ugate/ugate/README.md

# ugatefx
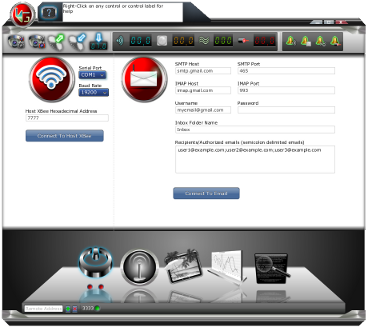
[picture p1: docs/screen01.png]

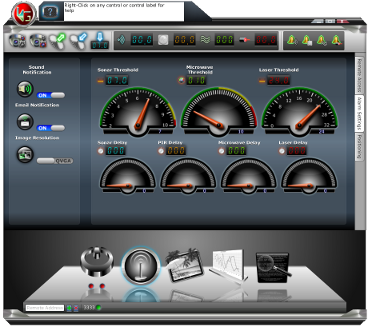
[picture p2: docs/screen02.png]

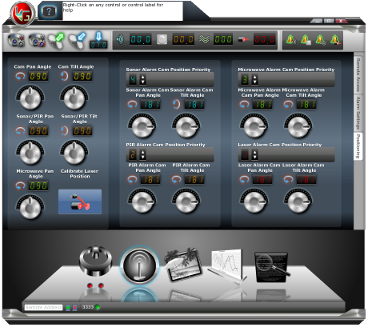
[picture p3: docs/screen03.png]

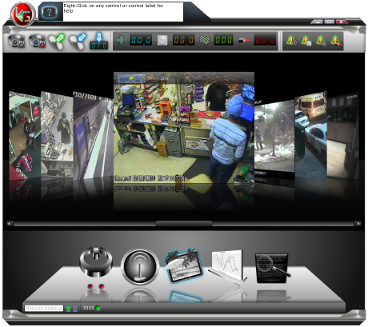
[picture p4: docs/screen04.png]

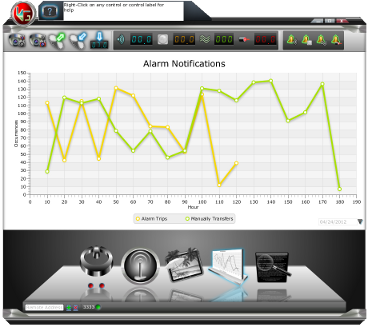
[picture p5: docs/screen05.png]

### Videos
Universal Remote (http://www.youtube.com/watch?v=NYPrsTqbBkM)
Camera Setup (http://www.youtube.com/watch?v=etdJuvhWalM)
Camera Dome (http://www.youtube.com/watch?v=nVsgEaDEsaw)
<h1><u>Summary:</u></h1>

<p><b>UGate is a fully configurable indoor/outdoor security system that:</b></p>
<ul> <li><b>Takes pictures (w/night vision) and sends an email with the picture as an attachment to predefined recipient(s).</b> <ol> <li>Via alarm sensor(s) trip</li> <li>Via IR Remote Control</li> <li>Via GUI Application</li> <li>Via remote web interface (embedded web server in GUI Application)</li> <li>Via receiving an email with device commands (initiated from a computer, mobile phone, or any other device that can send emails/text messages).</li> </ol> </li> <li><b>Remotely pan/tilt on-board camera.</b> <ol> <li>Via IR Remote Control</li> <li>Via GUI Application</li> <li>Via remote web interface (embedded web server in GUI Application)</li> <li>Via receiving an email with device commands (initiated from a computer, mobile phone, or any other device that can send emails/text messages).</li> </ol> </li> <li><b>Remotely pan/tilt alarm sensor orientation.</b> <ol> <li>Via IR Remote Control (all sensors except microwave)</li> <li>Via GUI Application (all sensors- pan only for microwave)</li> <li>Via remote web interface (embedded web server in GUI Application)</li> <li>Via receiving an email with device commands (all sensors- initiated from a computer, mobile phone, or any other device that can send emails/text messages).</li> </ol> </li> <li><b>Remotely open/close an entrance gate (optional).</b> <ol> <li>Via IR Remote Control</li> <li>Via GUI Application</li> <li>Via remote web interface (embedded in GUI Application)</li> <li>Via receiving an email with device commands (initiated from a computer, mobile phone, or any other device that can send emails/text messages).</li> </ol> </li> </ul>
## <a href="docs/features.md">Features</a>
## <a href="docs/userguide.md">User Guide</a>
