ugate/ugate/docs/videos.md

<div class="body2"><div class="main"><!-- content --><section id="content"><div class="marg_top wrapper"><article class="col1 video"><div class="box1_out"><div class="box1">

## Universal Remote

Universal Remote (http://www.youtube.com/watch?v=NYPrsTqbBkM)

## Camera Setup

Camera Setup (http://www.youtube.com/watch?v=etdJuvhWalM)</div><div class="box1_bot"><div class="box1_bot_left"></div></div></article></div></section><section id="content2"><div class="marg_top wrapper"><article class="col1 video"><div class="box1_out"><div class="box1">

## Camera Dome

Camera Dome (http://www.youtube.com/watch?v=nVsgEaDEsaw)</div></div><div class="box1_bot"><div class="box1_bot_left"></div></div></article></div></section><!-- / content --></div></div>
