ugate/ugate/docs/features.md

<section id="content"><div class="marg_top wrapper"><div class="box1_out"><div class="box1"><span style="white-space:nowrap;width:100%;">

## Core UGate Features

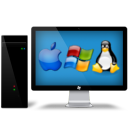
[picture p6: docs/desktop.png]
Desktop
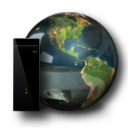
[picture p7: docs/webserver2.png]
Web Server
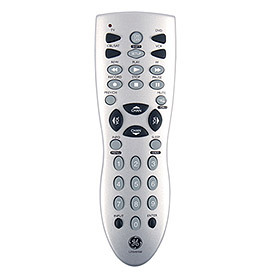
[picture p8: docs/GE-24944.jpg]
Universal Remote
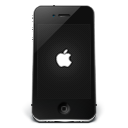
[picture p9: docs/iphone.png]
iPhone
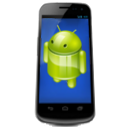
[picture p10: docs/android.png]
Android
[†](#feature_dep)</span><table id="featuretable" cellspacing="0" cellpadding="10" border="0" width="100%" align="center"><tbody><tr><th width="17%" valign="center" align="center"></th><th width="16%" valign="center" align="center"></th><th width="16%" valign="center" align="center"></th><th width="1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
