ugate/ugate/docs/cam14.jpg

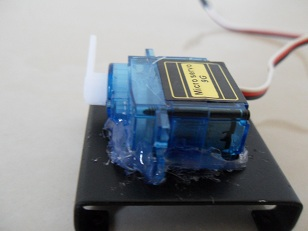
docs/cam14.jpg
