ugate/ugate/src/main/java/org/ugate/resources/gate-closed.png

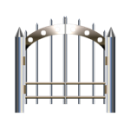
src/main/java/org/ugate/resources/gate-closed.png
