ugate/ugate/src/main/java/org/ugate/resources/gate-opened.png

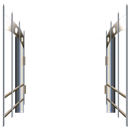
src/main/java/org/ugate/resources/gate-opened.png
