ugate/ugate/src/main/java/org/ugate/resources/graph.png

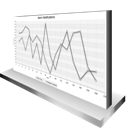
src/main/java/org/ugate/resources/graph.png
