ugate/ugate/src/main/java/org/ugate/resources/pics.png

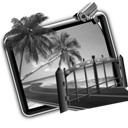
src/main/java/org/ugate/resources/pics.png
