ugate/ugate/src/main/java/org/ugate/resources/power-red.png

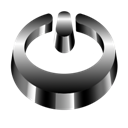
src/main/java/org/ugate/resources/power-red.png
