ugate/ugate/src/main/java/org/ugate/resources/web.png

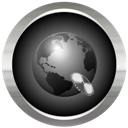
src/main/java/org/ugate/resources/web.png
