ugate/ugate/src/main/java/org/ugate/resources/wireless-globe.png

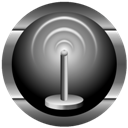
src/main/java/org/ugate/resources/wireless-globe.png
