ugate/ugate/(list of files, drawings)

Other design files:
src/main/config/fritzing/cam-servo-cal.fz
src/main/config/fritzing/ugate.fz
