ugate/ugate/(commit log)

2011-10-11 Added initial Arduino code (WARNING: not fully tested)
2011-10-12 Updated UGate.pde to reflect command codes described in wiki. Added a locked-in version of of xbee-arduino to ensure stability (permission granted by Andrew Rapp - author of lib). Extracted UGate.h h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
    [Exceptions.h, UGate.h, UGate.pde]
2011-10-24 Sending settings to arduino is now working (sent when application starts up). Removed toggle switch skin from component (took up too much resources)
    [UGate.pde]
2011-10-26 Updated toggle switch look-and-feel
2011-10-27 Corrected issue with dragging the application title bar when the min/max/close buttons are the drag target
2011-11-03 Renamed parameters within the gauge control to make their intent more explicit... remaining changes that need to be made to the gauge include: tick mark labels, current value display, intensity angle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
2011-11-08 Added tick value feature to the gauge control that allows a scaled value to be shown rather than an angle. Added angle calibration to ensure the angle set on the property conforms to the same range r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
2011-11-09 Updated tick value labels (not complete)... remaining changes that need to be made to the gauge include: tick mark labels with placement, current tick value display.
2011-11-10 Fixed some angle issues with the gauge control. Adjusted the highlight... remaining changes that need to be made to the gauge include: tick mark labels with placement, current tick value display.
2011-11-11 Completed gauge tick value labels. Added feature to offset the zero tick value... remaining changes that need to be made to the gauge include: current tick value display.
2011-11-11 Fixed issue with gauge control when setting the tick value (related to tick scale and tick zero offset)... remaining changes that need to be made to the gauge include: current tick value display.
2011-11-29 Fixed control help... now activated by right clicking on controls. Fixed issue with toggle switch that prevented value change when clicked.
2011-12-01 Added gate keeper listener and updated toggle switch preference view to accept multiple toggle switches that automatically sets the preference value based on the binary on/off state relative to the c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
2011-12-06 Moved the camera/sensor tabs to the right side of the center view
2011-12-12 Fixed issue with multiple transfers. Moved settings and commands to enum.
    [Command.java]
2011-12-14 Added the rest of the labels resource bundle. Updates related to the wireless/mail connections. Added access key code entry.
2011-12-27 Added mail/wireless connection GUI service
2011-12-28 Updated mail/wireless connection GUI service. Added help text to connection views.
2011-12-30 Updates related to incoming wireless data. Extracted sound feature into GUI. Added remaining gate keeper events.
2012-01-09 Added fritzing source and renamed resources folder to config.
    [cam-servo-cal.fz, ugate.fz]
2012-01-10 Added IR Receiver
    [ugate.fz]
2012-01-15 Fixed hanging issue with AWT thread from system tray
    [Command.java]
2012-01-24 Updated fritzing illustration
    [ugate.fz]
2012-01-27 Started adding laser to GUI
2012-01-30 Updated multi-alarm state to include visual notifications in GUI. Values include 0-16 (binary combinations for four sensors).
2012-01-31 Added sensor priorities for camera positioning when alarm(s) are tripped. Added laser cam pan/tilt angles for alarm triggers.
2012-02-01 Completed GUI priority options for camera position when an alarm is tripped.
2012-02-07 Visual updates to multi-alarm option, reading button, and settings buttons.
2012-02-08 Added Laser/IR Receiver (Tripwire) option for calibration. Added Laser threshold (needs adjustment to label display). Updated commands and command keys.
2012-02-09 Updated Laser/IR Receiver (Tripwire) gauge layout. Added laser calibration graphic to button.
2012-02-09 Updated Laser/IR Receiver (Tripwire) gauge range and default value.
2012-02-09 Updated Laser/IR Receiver (Tripwire) to show response message of the results of a calibration command.
2012-02-10 Added logic for adding new remote nodes by XBee address and switching between remote nodes by XBee address (does not yet update GUI when changed).
2012-02-13 Updated some laser testing (not complete)
2012-02-24 Moved remote node status buttons to taskbar. Fixed add/remove remote node functionality. Cosmetic changes.
2012-05-04 Migration to H2 DB back-end (not complete). Migrating to stand-alone Apache OpenJPA over H2 DB using Atomikos JTA. Started spring integration for transaction support (not fully working yet).
2012-05-07 Migration to H2 DB back-end (not complete). Migrated to stand-alone Apache OpenJPA over H2 DB using Atomikos JTA. Completed spring integration for transaction support.
2012-05-08 Migration to H2 DB back-end (not complete). Fixed maven build issues. Added JavaFX preloader. Cleaned up web server filters/servlets.
2012-05-24 Migration to H2 DB back-end (not complete). Added common model entity interface and model coupler for reflective binding of entities. Still getting error when running Maven build (not getting from ec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
2012-05-25 Migration to H2 DB back-end (not complete). Updated common model entity interface and model coupler for reflective binding of entities. Still getting error when running Maven build (not getting from 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
2012-05-29 Migration to H2 DB back-end (not complete). Corrected package of JDBC listener in spring-all.xml. Removed unused ModelCoupler class. Still getting error when running Maven build (not getting from ecl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
2012-06-12 Migration to H2 DB back-end (not complete). Updated BeanPathAdaptor to fix feature that switches the POJO bean on-the-fly. Still getting error when running Maven build (not getting from eclipse run):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
2012-06-13 Migration to H2 DB back-end (not complete). Updated BeanPathAdaptor to fix issues with switching beans that caused a ClassCastException, but still needs feature to bind to multiple JFX control proper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
2012-07-30 Migration to H2 DB back-end (not complete). UPDated BeanPathAdaptor for bidirectional binding on ObservableList, ObservableSet, and ObservableMap (still has issue with setBean and selection binding).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
    [PositionSettings.java, UGateCtrlView.java]
2012-08-06 Migration to H2 DB back-end (not complete). Updated BeanPathAdaptor for bidirectional binding on ObservableList, ObservableSet, and ObservableMap (still need to use same instances in collection as or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
    [PositionSettings.java]
2012-08-07 Migration to H2 DB back-end (not complete). Updated mail connection view for adding/removing mail recipients (currently orphaned recipients will exist when removing that will cause unique constraint 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
2012-08-10 Upgraded Spring from 3.1.1.RELEASE to 3.1.2.RELEASE
2012-08-22 Migration to H2 DB back-end (DB re-org). Added option to remote nodes that allows for an auto synchronization between the remote device and the locally persisted values.
2012-09-05 Added RemodeNodeReading for capture and audit of sensor reading data.
2012-09-07 DB Reorg for RemoteNode. Added fields to for turning all alarms off and option to report incoming sensor readings as they occur on the remote device (even when an alarm is not triggered). Added date/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
2012-09-11 Added webserver start button. Upgraded/Tested maven-shade-plugin to version 2.0. Upgraded/Tested Jetty version to 8.1.6.v20120903
2012-09-18 Updates to sensor readings history
2012-09-20 Fixed all known issues pertaining to the sensor readings history view. Started WebBuilder view for browser access.
2012-10-17 Added WebSocket feature to web page in order to get real time updates. Fixed issues with remote node not getting updated when a DB update is selected after the 1st or 2nd try (DB update now only trie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
2012-10-24 Updated Gauge component so that while the tick value is updated from a needle drag the value will not get persisted until the needle is released. Started Command execution for web access and wireless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
2012-11-01 Converted web framework from Wicket to Servlet + Thymeleaf.
2012-11-13 Fixed remote node connection status request via web access.
    [Command.java]
2012-11-16 Fixed WebSocket display indicator on web page. Added web error page handler. Started Command generation of web elements. Fixed DisplayShelf image malformed URL issue.
    [Command.java]
2012-11-19 Updated UGateXBeePacketListener to accept multiple images coming from multiple remote node device sources. Continued web access for Commands.
2012-11-29 Various fixes. Updated image capture to send email notifications to the designated mail recipients (when email is connected and an image capture is initiated from a remote source- like an alarm, not 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
2012-12-12 Removed Platform.runLater(Runnable) from selections updates in BeanPathAdapter in order to calibrate timing of FieldPathValue change notifications.
2012-12-14 Fixed issue with change notifications that would occur for dirty data. Added additional global filtering options when listening for bean/field/collection/map/selection level changes.
2012-12-18 Upgraded Spring to 3.2.0. Added auto-save to user/Actor fields.
2013-01-02 Corrected connection icon click to connect to local wireless versus web
2013-01-02 Fixed title bar mouse drag that caused window to drag when the control bar was dragged (was due to drop shadow of help text). Removed button text updates to connection views in favor of setting help 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
2013-01-03 Moved native Windows WIX installer build to Windows profile. Added drop-in resource for JVM JCE JAR needed for HTTPS connections (currently not copying over to bundled JVM).
2013-01-07 Fixed runtime application icon. Added some install instructions regarding the CP210x USB to UART Bridge VCP Drivers (may want to automatically install the drivers during installation).
2013-01-07 Updated install instructions regarding the CP210x USB to UART Bridge VCP Drivers (may want to automatically install the drivers during installation).
2013-01-28 Moved Atomikos TX from transactions.properties to Spring configuration
2013-03-15 Updated: Jetty to version 9.0.0.v20130308. maven-dependency-plugin to version 2.7. Added: ServiceProvider Java debug mode detection that will automatically switch the application logback logger to DE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
